chowdhuryRakibul/PICdevelopmentBoard/manual/board 1/board1.jpg

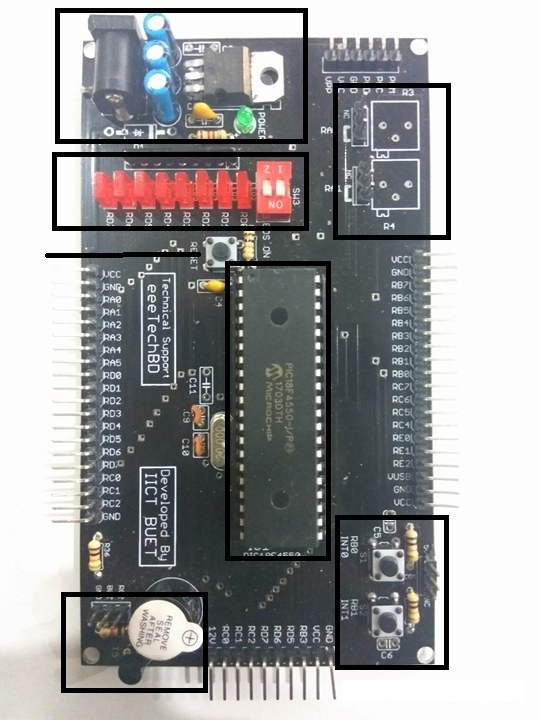
manual/board 1/board1.jpg
