chowdhuryRakibul/PICdevelopmentBoard/manual/board 1/board1_edited.jpg

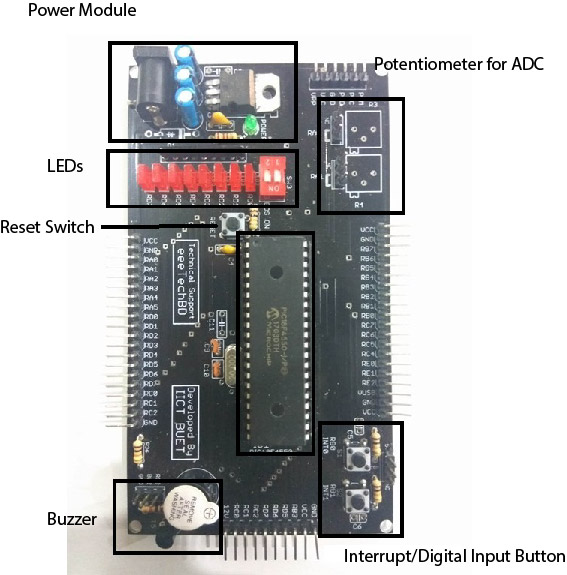
manual/board 1/board1_edited.jpg
