chowdhuryRakibul/PICdevelopmentBoard/README.md

# PICdevelopmentBoard

An educational PIC development board developed in 2017-18 for Institute of Information and Communication Technology, BUET, Dhaka.

The project contains 3 folders.
PCB includes the PCB design of individual boards using Eagle
Manual includes detailed of how to use each board with corresponding snippet of Schematic and pin mapping
Source Code includes bare-metal C/C++ code for testing basic functionalities
