chowdhuryRakibul/PICdevelopmentBoard/(list of files, drawings)

Other design files:
Source Code/Source Code/Serial Communication/Serial com.DSN
