chowdhuryRakibul/PICdevelopmentBoard/PCB/PIC Development Board.brd

## EAGLE design PCB/PIC Development Board.brd (2020-09-23)

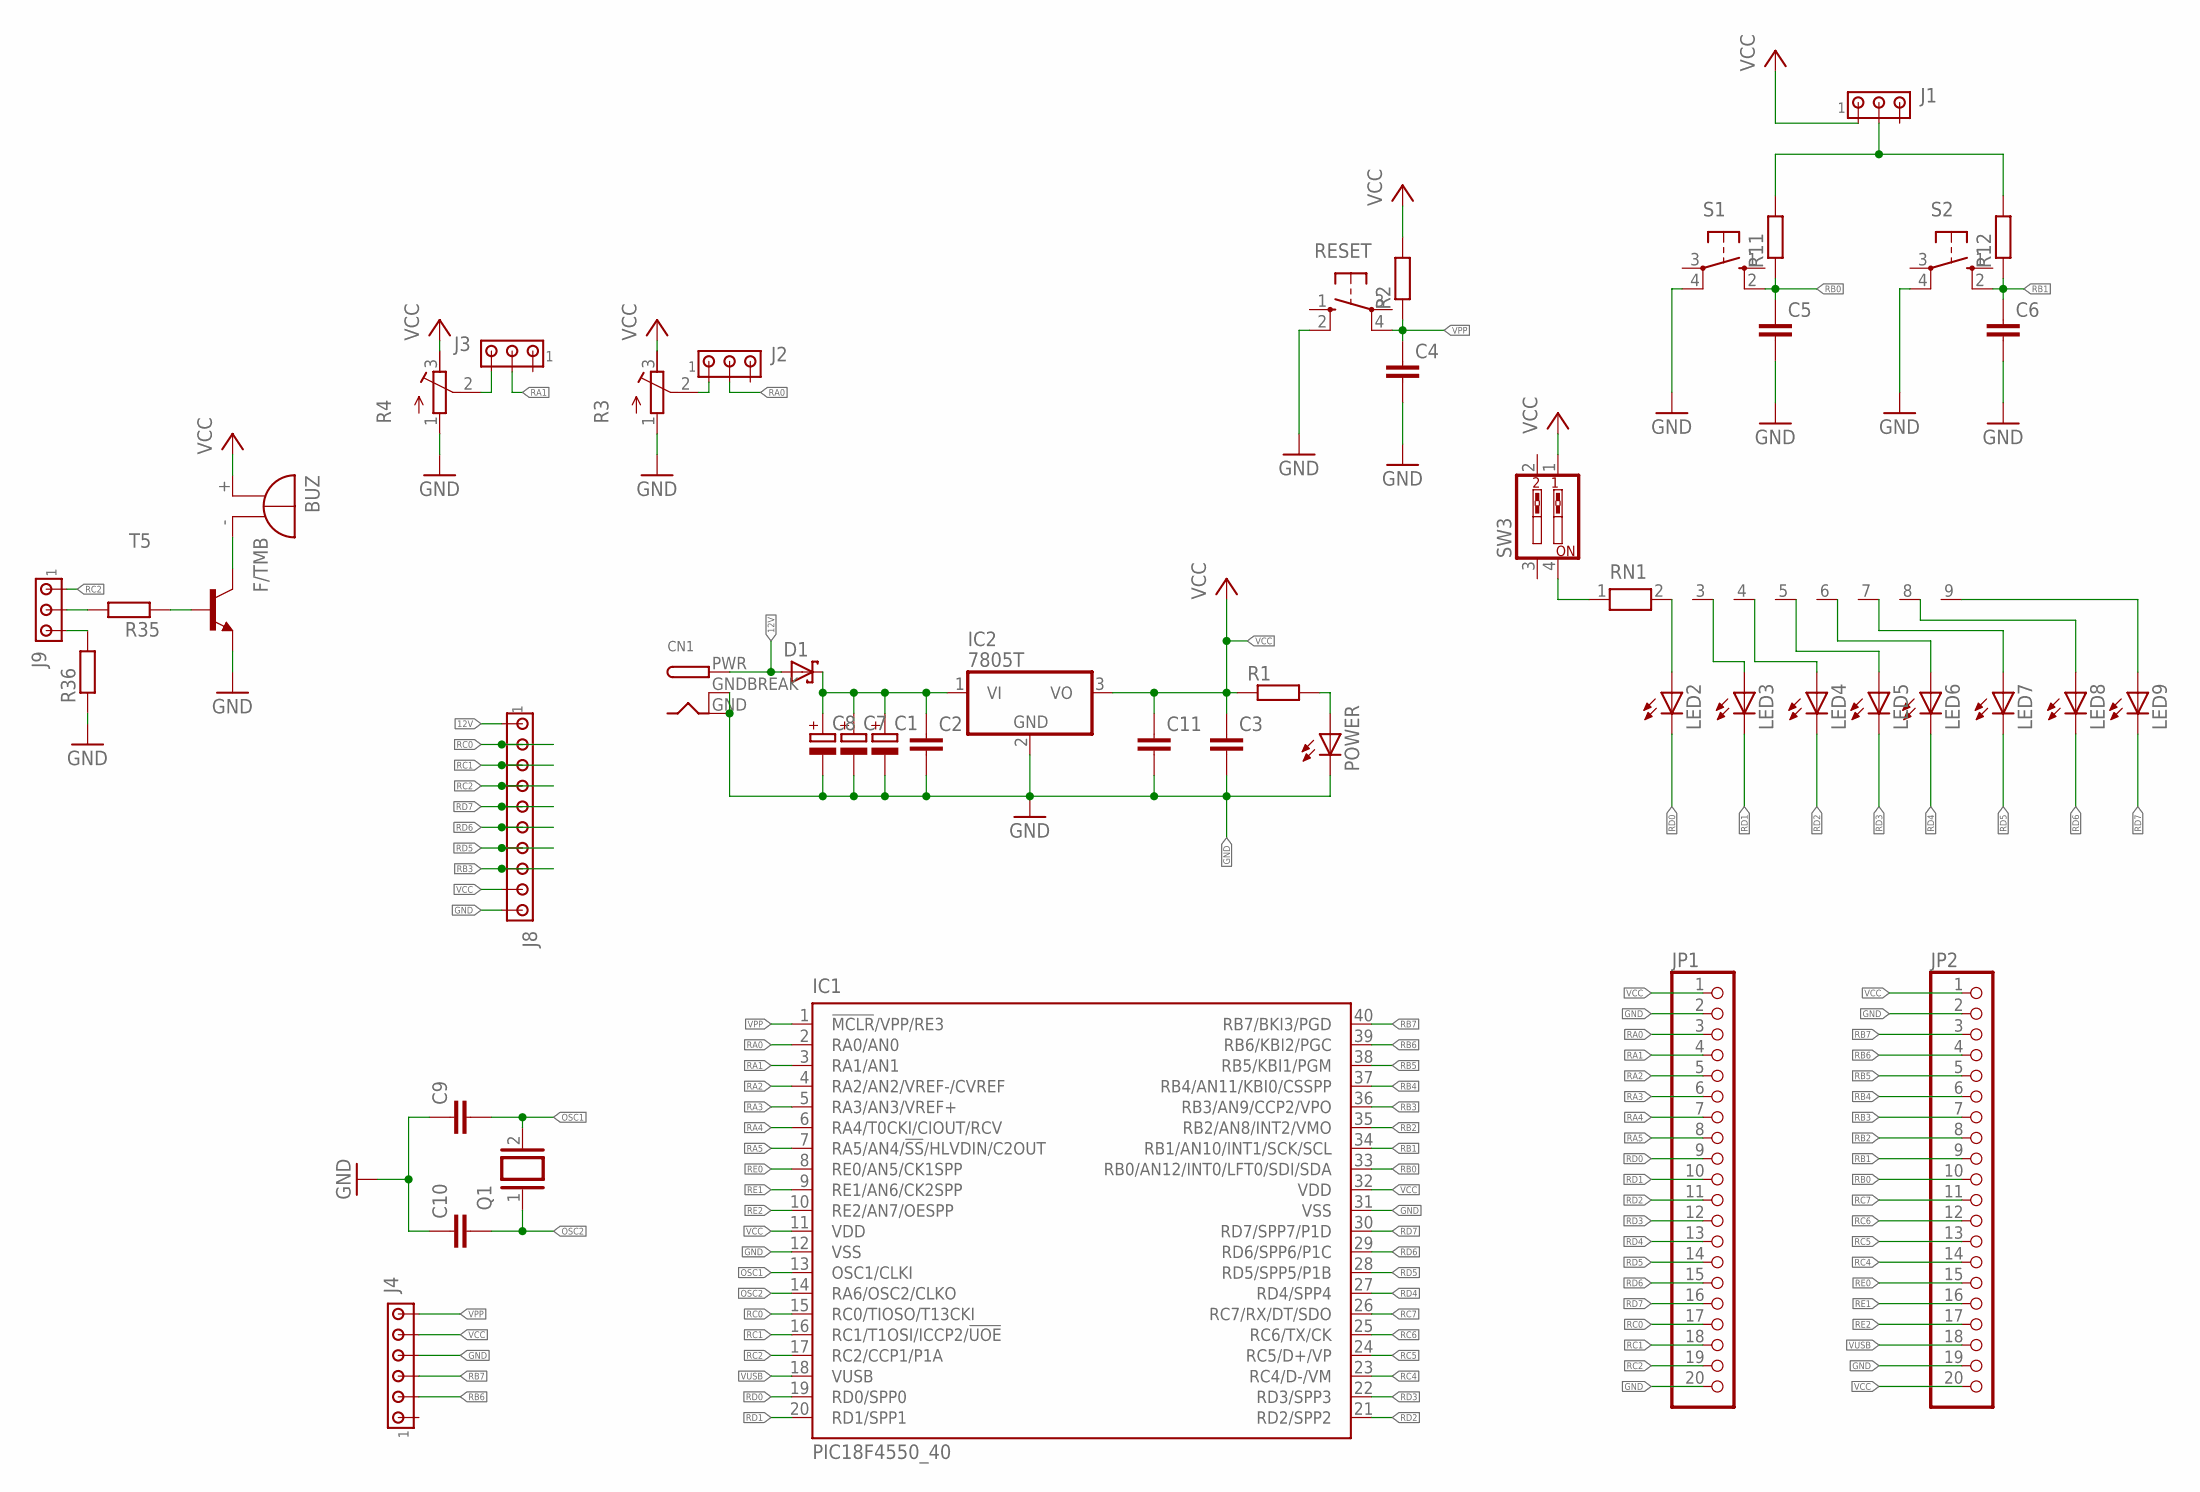
[picture p19: schematic PIC Development Board.sch, sheet 1]

Parts:
BUZ: F/TMB
C1, C7, C8: CPOL-EUE2,5-6E; E2,5-6E
C2, C3, C4, C11: C-EU050-025X075; C050-025X075
C5, C6: C-EU025-024X044; C025-024X044
C9, C10: C-EU025-030X050; C025-030X050
CN1: DCBARRELPTH; DCJACK_2MM_PTH
D1: SCHOTTKY-DIODEF126Z12; F126Z12
IC1: PIC18F4550_40; DIL40
IC2: 7805T; TO220H
J1, J2, J3, J9: MTA03-100; 10X03MTA
J4: MTA06-100; 10X06MTA
J8: MTA10-100; 10X10MTA
JP1, JP2: PINHD-1X20; 1X20
LED2, LED3, LED4, LED5, LED6, LED7, LED8, LED9: LEDSQR2X5; LED2X5
POWER: LED3MM
Q1: XTAL/S; QS
R1, R2, R11, R12, R35, R36: R-EU_0204/7; 0204/7
R3, R4: R-TRIMM3296P; RTRIM3296P
RESET: 10-XX; B3F-10XX
RN1: RN08; RN-9
S1, S2: 10-XX; B3F-10XX
SW3: SW_DIP-2; EDG-02
T5: BC547A-NPN-TO92-CBE; TO92-CBE

Connections:
12V: CN1.PWR, D1.A, J8.1
GND: C1.-, C2.2, C3.2, C4.2, C5.2, C6.2, C7.-, C8.-, C9.1, C10.1, C11.2, CN1.GND, CN1.GNDBREAK, IC1.12 (VSS), IC1.31 (VSS), IC2.2 (GND), J4.4, J8.10, JP1.2, JP1.20, JP2.2, JP2.19, POWER.K (C), R3.1 (A), R4.1 (A), R36.1, RESET.2 (S1), S1.4 (P1), S2.4 (P1), T5.E; also elsewhere on the board
unnamed: C1.+, C2.1, C7.+, C8.+, D1.C, IC2.1 (VI)
unnamed: LED2.A, RN1.2
unnamed: J9.2, R35.2
unnamed: LED3.A, RN1.3
unnamed: POWER.A, R1.2
unnamed: J2.1, R3.2 (S)
unnamed: LED4.A, RN1.4
unnamed: LED5.A, RN1.5
unnamed: LED6.A, RN1.6
unnamed: LED7.A, RN1.7
unnamed: LED8.A, RN1.8
unnamed: LED9.A, RN1.9
unnamed: J3.3, R4.2 (S)
unnamed: RN1.1, SW3.4
unnamed: J1.2, R11.2, R12.2
unnamed: BUZ.-, T5.C
unnamed: R35.1, T5.B
unnamed: J9.3, R36.2
OSC1: C9.2, IC1.13 (OSC1/CLKI), Q1.2
OSC2: C10.2, IC1.14 (RA6/OSC2/CLKO), Q1.1
RA0: IC1.2 (RA0/AN0), J2.2, JP1.3; also elsewhere on the board
RA1: IC1.3 (RA1/AN1), J3.2, JP1.4; also elsewhere on the board
RA2: IC1.4 (RA2/AN2/VREF-/CVREF), JP1.5; also elsewhere on the board
RA3: IC1.5 (RA3/AN3/VREF+), JP1.6; also elsewhere on the board
RA4: IC1.6 (RA4/T0CKI/CIOUT/RCV), JP1.7; also elsewhere on the board
RA5: IC1.7 (RA5/AN4/!SS!/HLVDIN/C2OUT), JP1.8; also elsewhere on the board
RB0: C5.1, IC1.33 (RB0/AN12/INT0/LFT0/SDI/SDA), JP2.10, R11.1, S1.2 (S1); also elsewhere on the board
RB1: C6.1, IC1.34 (RB1/AN10/INT1/SCK/SCL), JP2.9, R12.1, S2.2 (S1); also elsewhere on the board
RB2: IC1.35 (RB2/AN8/INT2/VMO), JP2.8; also elsewhere on the board
RB3: IC1.36 (RB3/AN9/CCP2/VPO), J8.8, JP2.7; also elsewhere on the board
RB4: IC1.37 (RB4/AN11/KBI0/CSSPP), JP2.6; also elsewhere on the board
RB5: IC1.38 (RB5/KBI1/PGM), JP2.5; also elsewhere on the board
RB6: IC1.39 (RB6/KBI2/PGC), J4.2, JP2.4; also elsewhere on the board
RB7: IC1.40 (RB7/BKI3/PGD), J4.3, JP2.3; also elsewhere on the board
RC0: IC1.15 (RC0/TIOSO/T13CKI), J8.2, JP1.17; also elsewhere on the board
RC1: IC1.16 (RC1/T1OSI/ICCP2/!UOE), J8.3, JP1.18; also elsewhere on the board
RC2: IC1.17 (RC2/CCP1/P1A), J8.4, J9.1, JP1.19; also elsewhere on the board
RC4: IC1.23 (RC4/D-/VM), JP2.14; also elsewhere on the board
RC5: IC1.24 (RC5/D+/VP), JP2.13; also elsewhere on the board
RC6: IC1.25 (RC6/TX/CK), JP2.12; also elsewhere on the board
RC7: IC1.26 (RC7/RX/DT/SDO), JP2.11; also elsewhere on the board
RD0: IC1.19 (RD0/SPP0), JP1.9, LED2.K (C); also elsewhere on the board
RD1: IC1.20 (RD1/SPP1), JP1.10, LED3.K (C); also elsewhere on the board
RD2: IC1.21 (RD2/SPP2), JP1.11, LED4.K (C); also elsewhere on the board
RD3: IC1.22 (RD3/SPP3), JP1.12, LED5.K (C); also elsewhere on the board
RD4: IC1.27 (RD4/SPP4), JP1.13, LED6.K (C); also elsewhere on the board
RD5: IC1.28 (RD5/SPP5/P1B), J8.7, JP1.14, LED7.K (C); also elsewhere on the board
RD6: IC1.29 (RD6/SPP6/P1C), J8.6, JP1.15, LED8.K (C); also elsewhere on the board
RD7: IC1.30 (RD7/SPP7/P1D), J8.5, JP1.16, LED9.K (C); also elsewhere on the board
RE0: IC1.8 (RE0/AN5/CK1SPP), JP2.15; also elsewhere on the board
RE1: IC1.9 (RE1/AN6/CK2SPP), JP2.16; also elsewhere on the board
RE2: IC1.10 (RE2/AN7/OESPP), JP2.17; also elsewhere on the board
VCC: BUZ.+, C3.1, C11.1, IC1.11 (VDD), IC1.32 (VDD), IC2.3 (VO), J1.1, J4.5, J8.9, JP1.1, JP2.1, JP2.20, R1.1, R2.2, R3.3 (E), R4.3 (E), SW3.1; also elsewhere on the board
VPP: C4.1, IC1.1 (!MCLR!/VPP/RE3), J4.6, R2.1, RESET.4 (P1)
VUSB: IC1.18 (VUSB), JP2.18; also elsewhere on the board

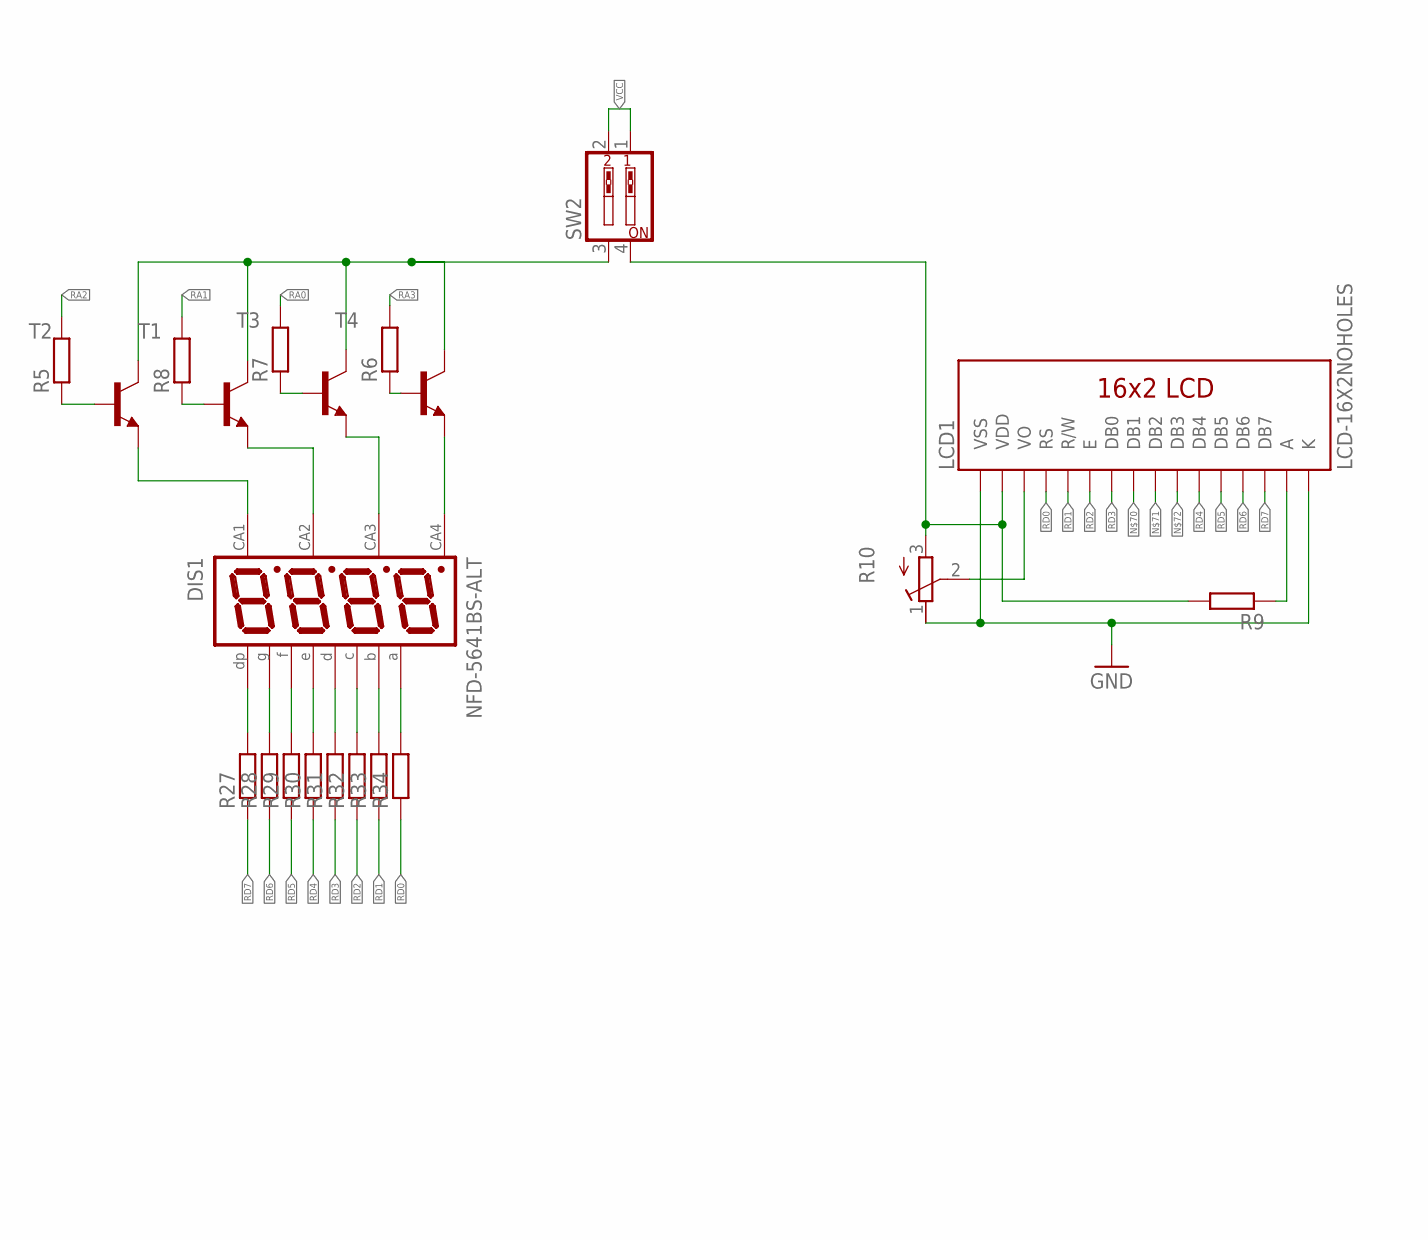
[picture p20: schematic PIC Development Board.sch, sheet 2, part in row 1, column 1]

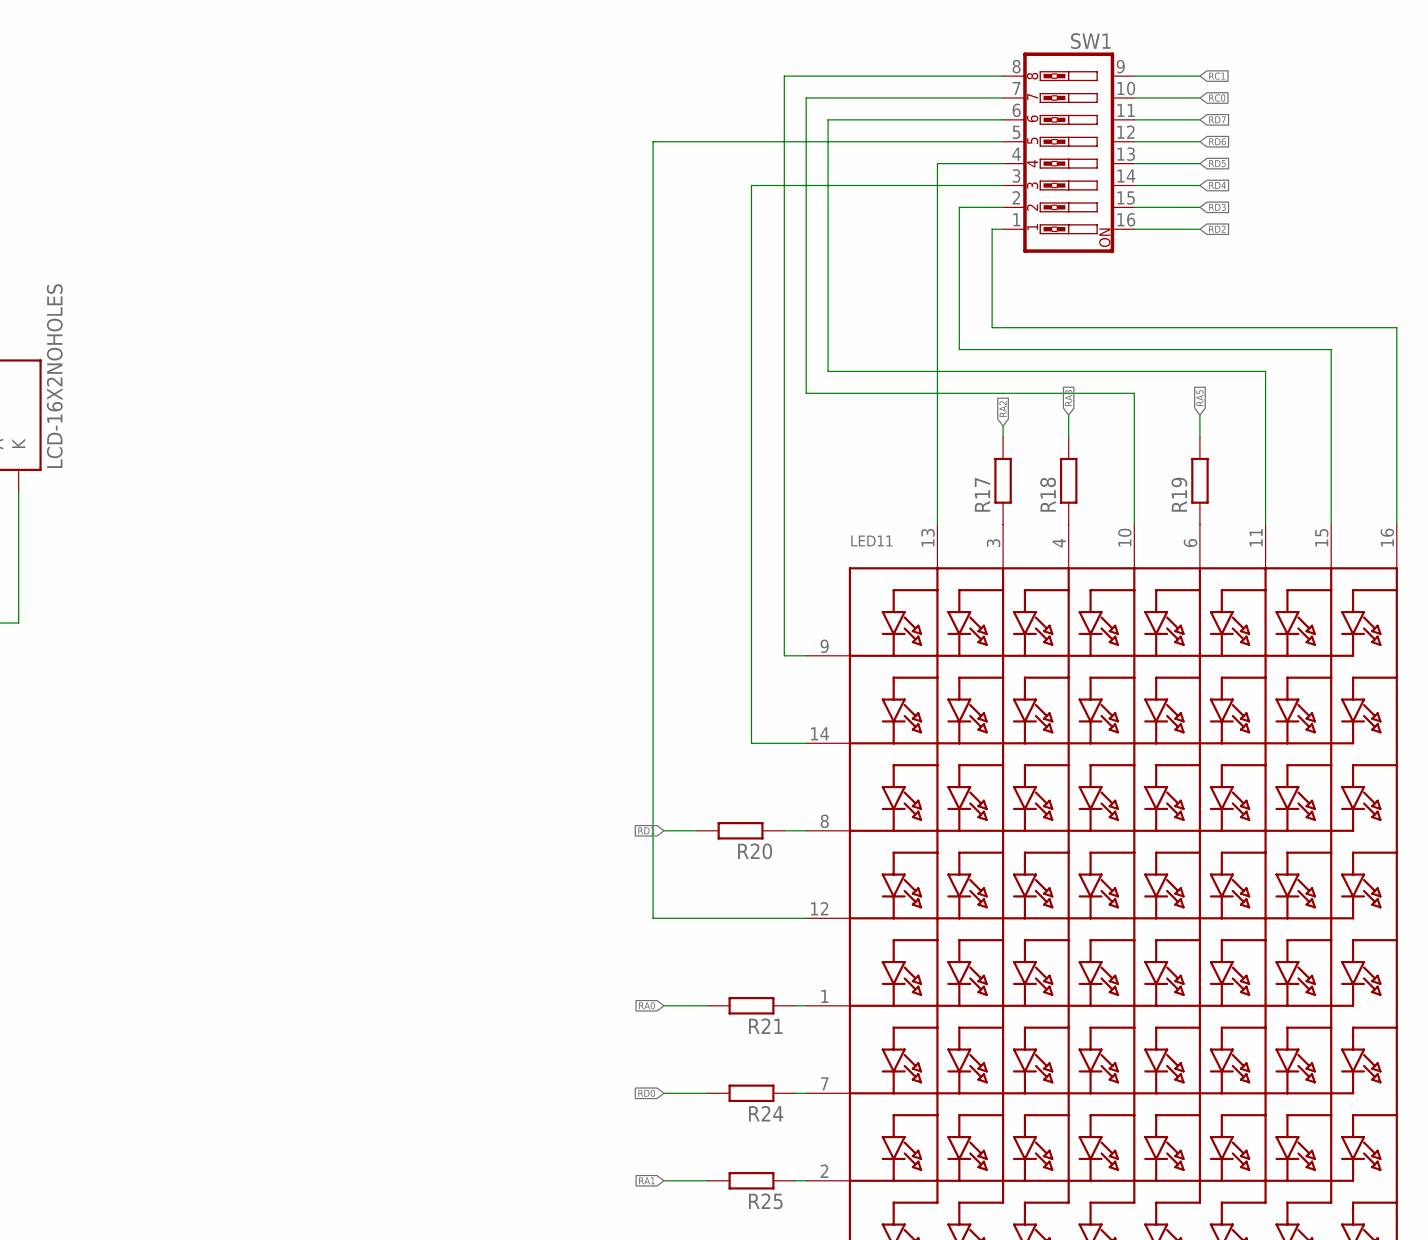
[picture p21: schematic PIC Development Board.sch, sheet 2, part in row 1, column 2]

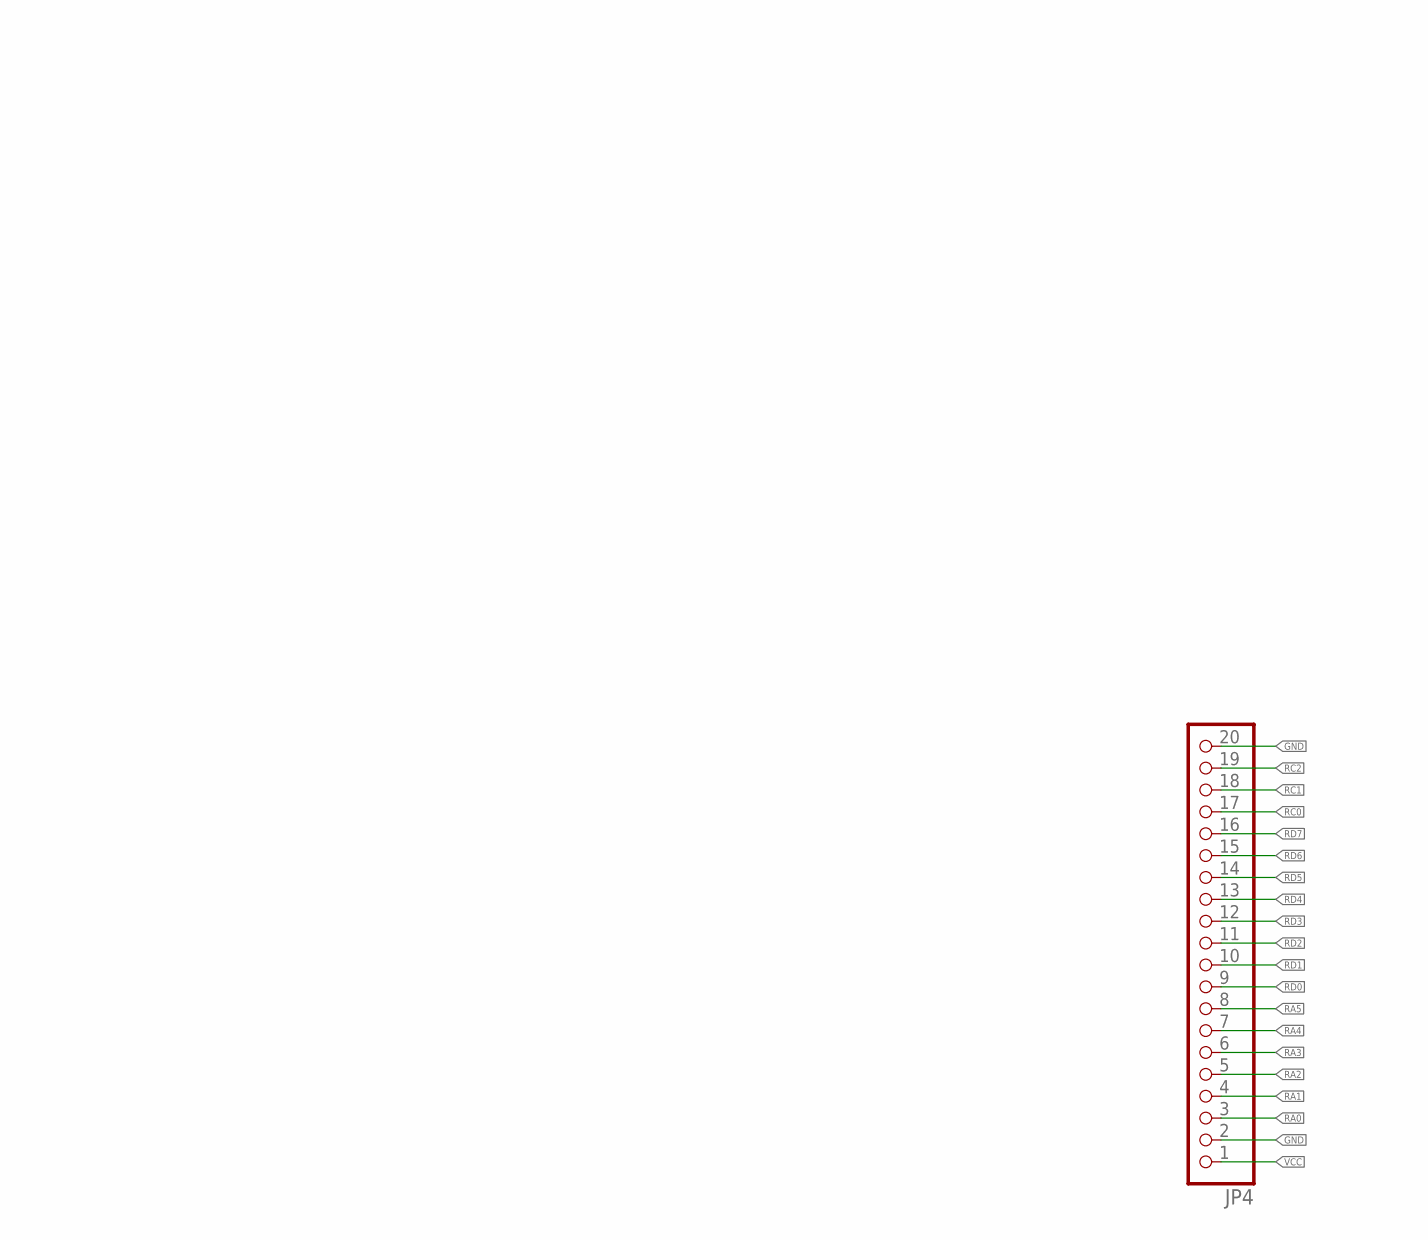
[picture p22: schematic PIC Development Board.sch, sheet 2, part in row 2, column 1]

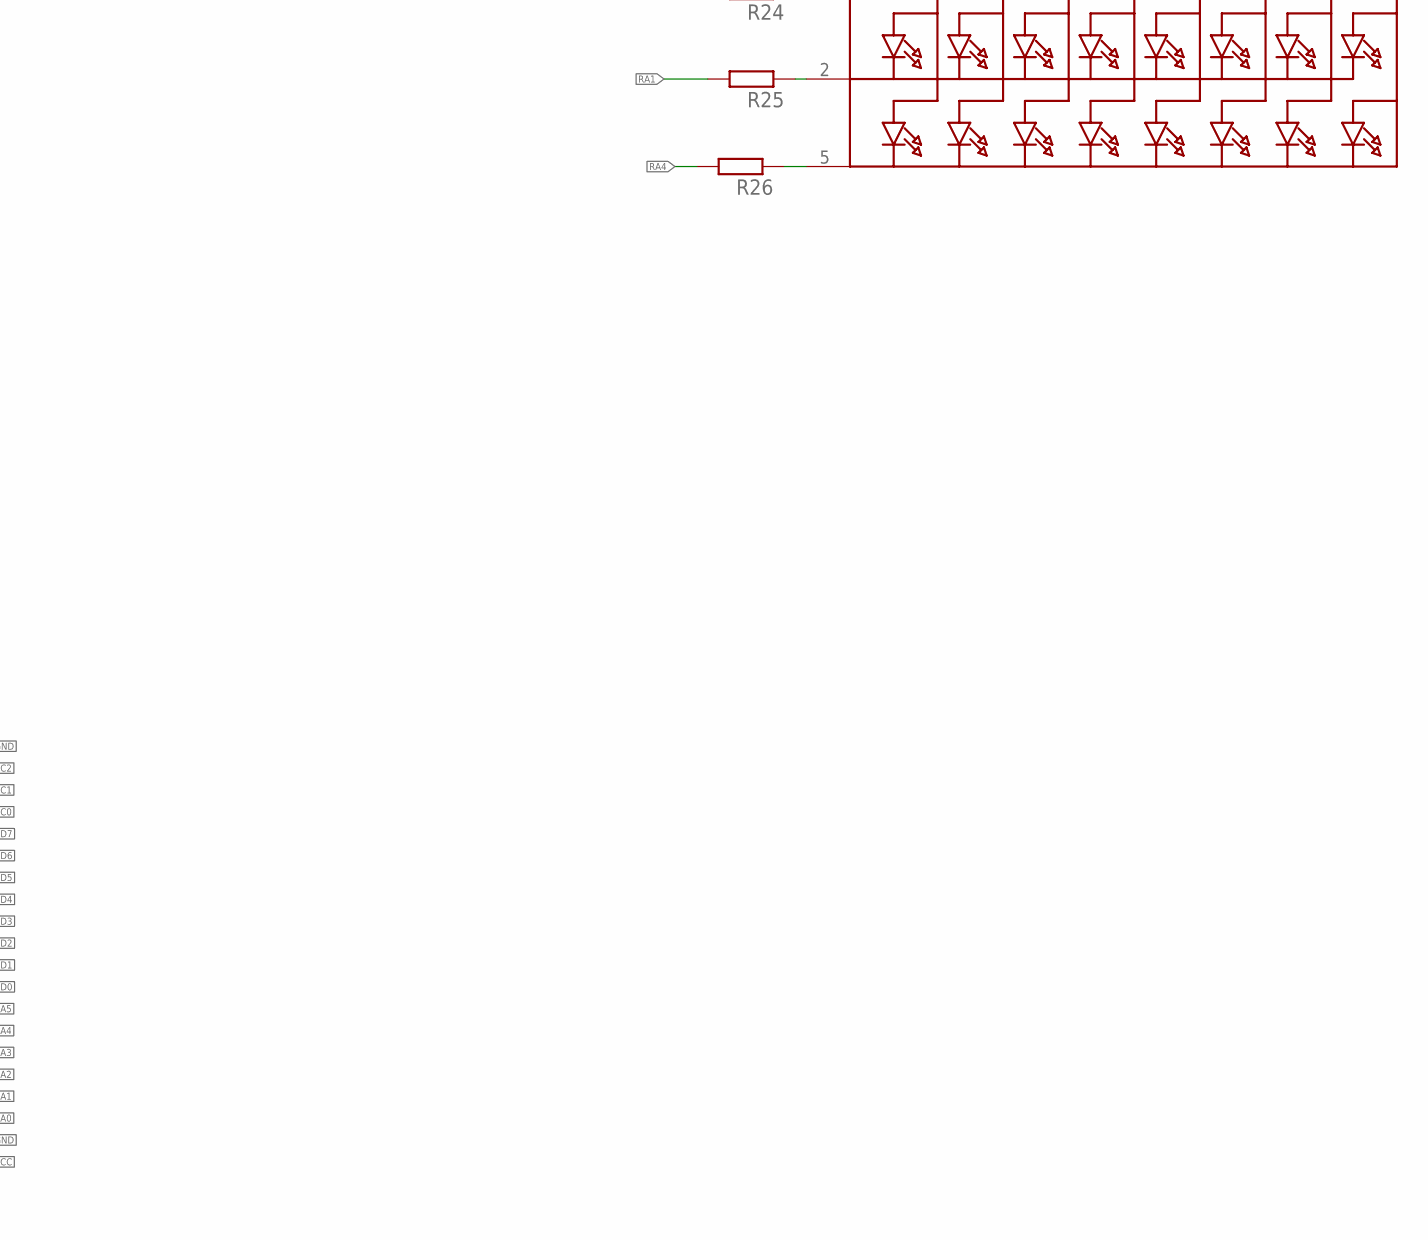
[picture p23: schematic PIC Development Board.sch, sheet 2, part in row 2, column 2]

Parts:
DIS1: NFD-5641BS-ALT; NFD-5641
JP4: PINHD-1X20; 1X20
LCD1: LCD-16X2NOHOLES; LCD-16X2_NOHOLESNOSILK
LED11: SEGMENT_8X8_ROWCATHODEM12A881UR; SEGMENT_BL-M12A881UR
R5, R6, R7, R8, R9, R17, R18, R19, R20, R21, R24, R25, R26, R27, R28, R29, R30, R31, R32, R33, R34: R-EU_0204/7; 0204/7
R10: R-TRIMMT93YA; RTRIMT93YA
SW1: SW_DIP-8; EDG-08
SW2: SW_DIP-2; EDG-02
T1, T2, T3, T4: BC547-NPN-TO92-CBE; TO92-CBE

Connections:
GND: JP4.2, JP4.20, LCD1.1 (VSS), LCD1.16 (K), R10.1 (E); also elsewhere on the board
unnamed: DIS1.P$8, T3.E
unnamed: DIS1.P$9, T1.E
unnamed: DIS1.P$12, T2.E
unnamed: LCD1.15 (A), R9.1
unnamed: LCD1.3 (VO), R10.2 (S)
unnamed: DIS1.P$6, T4.E
unnamed: SW2.3, T1.C, T2.C, T3.C, T4.C
unnamed: R6.1, T4.B
unnamed: R7.1, T3.B
unnamed: R8.1, T1.B
unnamed: R5.1, T2.B
unnamed: LCD1.2 (VDD), R9.2, R10.3 (A), SW2.4
unnamed: LED11.9 (K1), SW1.8
unnamed: LED11.10 (A4), SW1.7
unnamed: LED11.11 (A6), SW1.6
unnamed: LED11.12 (K4), SW1.5
unnamed: LED11.14 (K2), SW1.3
unnamed: LED11.6 (A5), R19.1
unnamed: LED11.4 (A3), R18.1
unnamed: LED11.3 (A2), R17.1
unnamed: LED11.8 (K3), R20.1
unnamed: LED11.1 (K5), R21.1
unnamed: LED11.7 (K6), R24.1
unnamed: LED11.2 (K7), R25.1
unnamed: LED11.5 (K8), R26.1
unnamed: DIS1.P$3, R27.2
unnamed: DIS1.P$5, R28.2
unnamed: DIS1.P$10, R29.2
unnamed: DIS1.P$1, R30.2
unnamed: DIS1.P$2, R31.2
unnamed: DIS1.P$4, R32.2
unnamed: DIS1.P$7, R33.2
unnamed: DIS1.P$11, R34.2
RA0: JP4.3, R7.2, R21.2; also elsewhere on the board
RA1: JP4.4, R8.2, R25.2; also elsewhere on the board
RA2: JP4.5, R5.2, R17.2; also elsewhere on the board
RA3: JP4.6, R6.2, R18.2; also elsewhere on the board
RA4: JP4.7, R26.2; also elsewhere on the board
RA5: JP4.8, R19.2; also elsewhere on the board
RC0: JP4.17, SW1.10; also elsewhere on the board
RC1: JP4.18, SW1.9; also elsewhere on the board
RC2: JP4.19; also elsewhere on the board
RD0: JP4.9, LCD1.4 (RS), R24.2, R34.1; also elsewhere on the board
RD1: JP4.10, LCD1.5 (R/W), R20.2, R33.1; also elsewhere on the board
RD2: JP4.11, LCD1.6 (E), LED11.16 (A8), R32.1, SW1.1, SW1.16; also elsewhere on the board
RD3: JP4.12, LCD1.7 (DB0), LED11.15 (A7), R31.1, SW1.2, SW1.15; also elsewhere on the board
RD4: JP4.13, LCD1.11 (DB4), R30.1, SW1.14; also elsewhere on the board
RD5: JP4.14, LCD1.12 (DB5), LED11.13 (A1), R29.1, SW1.4, SW1.13; also elsewhere on the board
RD6: JP4.15, LCD1.13 (DB6), R28.1, SW1.12; also elsewhere on the board
RD7: JP4.16, LCD1.14 (DB7), R27.1, SW1.11; also elsewhere on the board
VCC: JP4.1, SW2.1, SW2.2; also elsewhere on the board

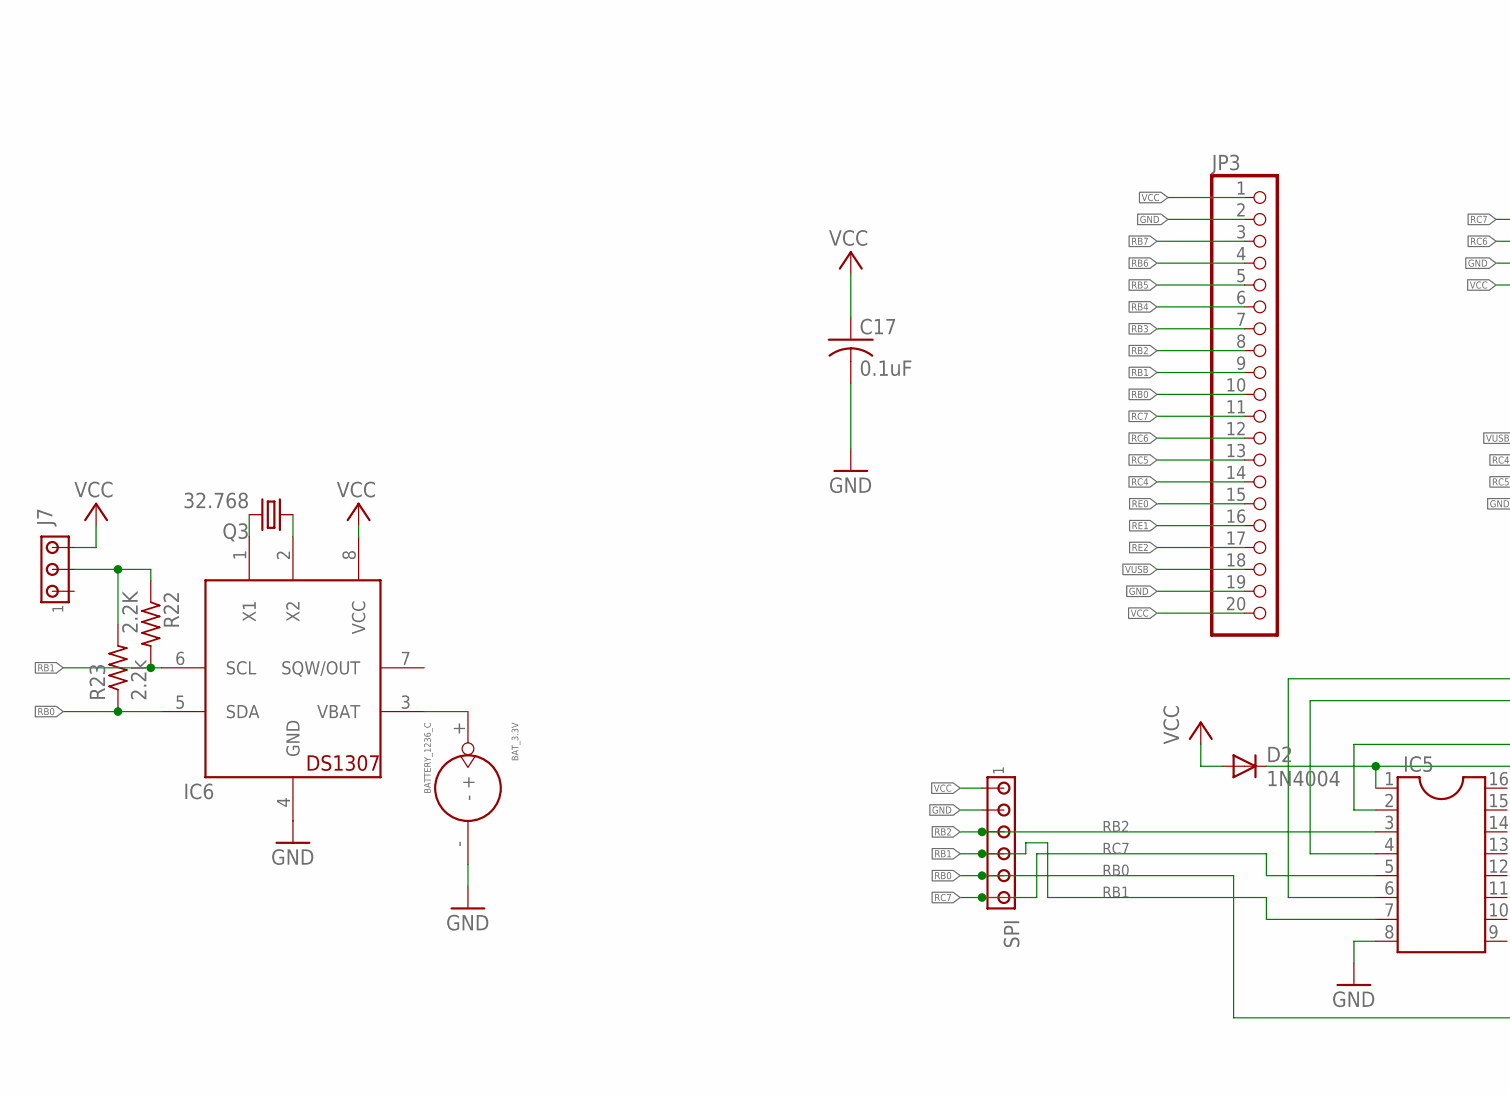
[picture p24: schematic PIC Development Board.sch, sheet 3, part in row 1, column 1]

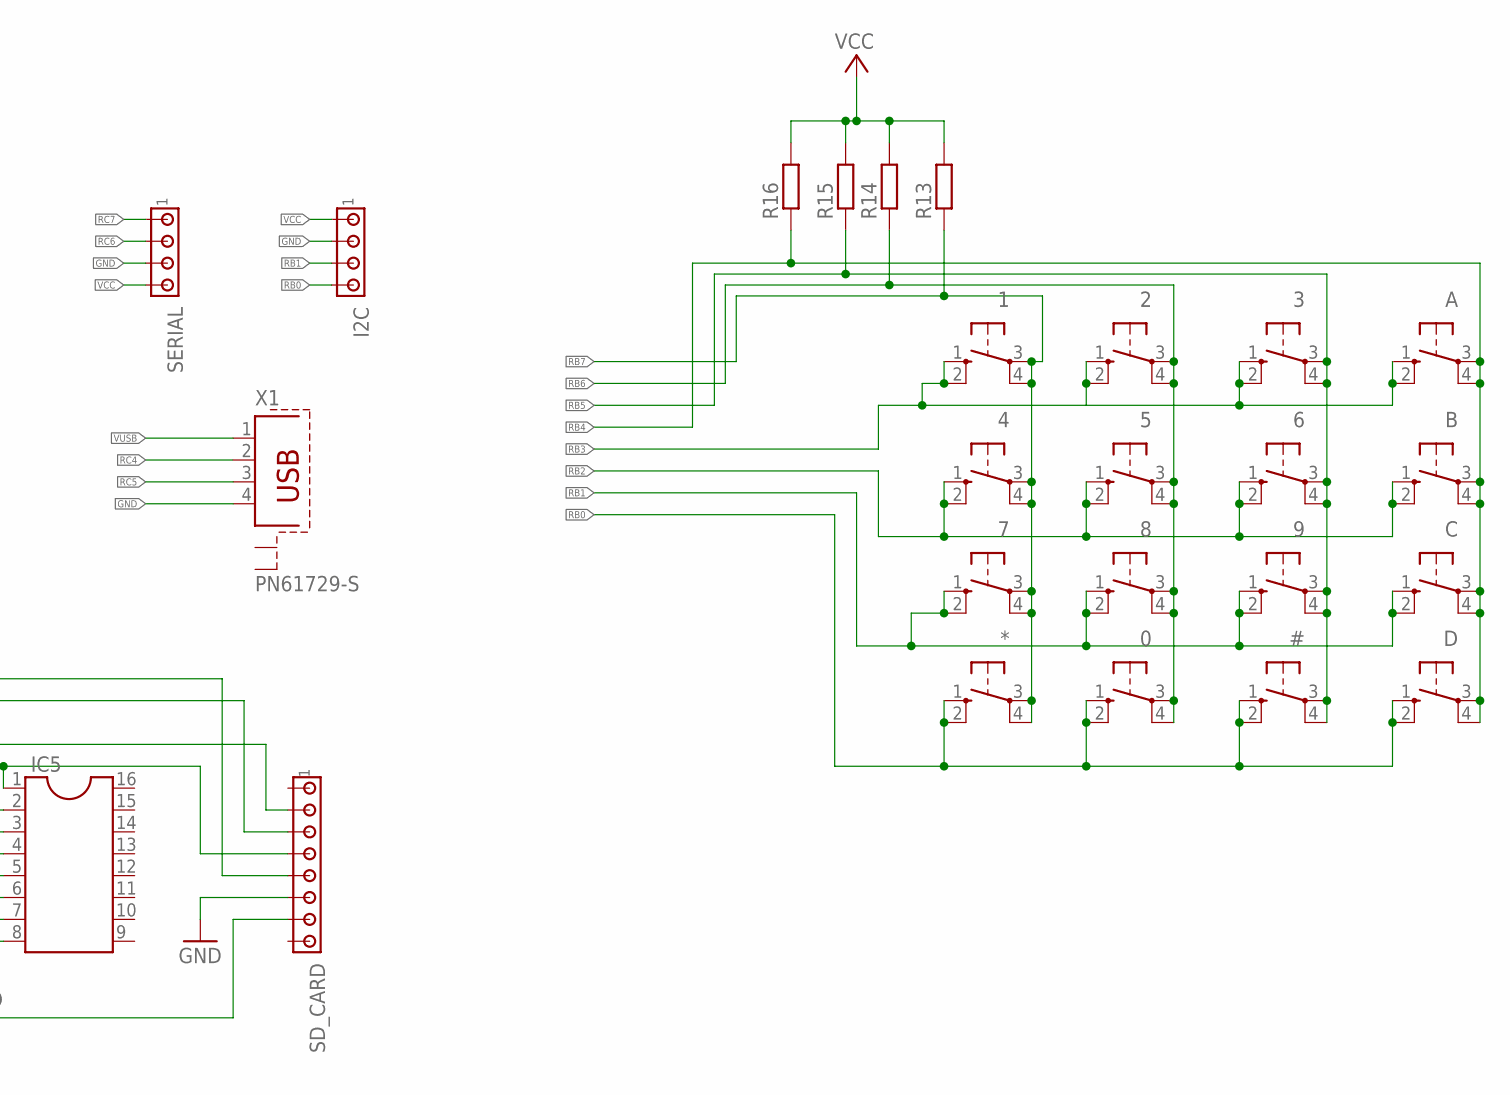
[picture p25: schematic PIC Development Board.sch, sheet 3, part in row 1, column 2]

Parts:
0, 1, 2, 3, 4, 5, 6, 7, 8, 9: 10-XX; B3F-10XX
#: 10-XX; B3F-10XX
*: 10-XX; B3F-10XX
A: 10-XX; B3F-10XX
B: 10-XX; B3F-10XX
BAT_3.3V: BATTERY_1236_C
C: 10-XX; B3F-10XX
C17: 0.1uF; C025-025X050
D: 10-XX; B3F-10XX
D2: 1N4004; DO41-10
I2C: MTA04-100; 10X04MTA
IC5: DIL16
IC6: DS1307; DIL08
J7: MTA03-100; 10X03MTA
JP3: PINHD-1X20; 1X20
Q3: 32.768; TC38H
R13, R14, R15, R16: R-EU_0204/7; 0204/7
R22: 2.2K; 0204/7
R23: 2.2k; 0204/7
SD_CARD: MTA08-100; 10X08MTA
SERIAL: MTA04-100; 10X04MTA
SPI: MTA06-100; 10X06MTA
X1: PN61729-S

Connections:
GND: BAT_3.3V.-, C17.2, I2C.2, IC5.8, IC6.4 (GND), JP3.2, JP3.19, SD_CARD.6, SERIAL.3, SPI.2, X1.4; also elsewhere on the board
unnamed: J7.2, R22.1, R23.2
unnamed: IC6.1 (X1), Q3.2
unnamed: IC6.2 (X2), Q3.1
unnamed: BAT_3.3V.+, IC6.3 (VBAT)
unnamed: D2.C, IC5.1, SD_CARD.4
unnamed: IC5.2, SD_CARD.2
unnamed: IC5.4, SD_CARD.3
unnamed: IC5.6, SD_CARD.5
RB0: 0.1 (S), 0.2 (S1), #.1 (S), #.2 (S1), *.1 (S), *.2 (S1), D.1 (S), D.2 (S1), I2C.4, IC6.5 (SDA), JP3.10, R23.1, SD_CARD.7, SPI.5; also elsewhere on the board
RB1: 7.1 (S), 7.2 (S1), 8.1 (S), 8.2 (S1), 9.1 (S), 9.2 (S1), C.1 (S), C.2 (S1), I2C.3, IC5.7, IC6.6 (SCL), JP3.9, R22.2, SPI.4; also elsewhere on the board
RB2: 4.1 (S), 4.2 (S1), 5.1 (S), 5.2 (S1), 6.1 (S), 6.2 (S1), B.1 (S), B.2 (S1), IC5.3, JP3.8, SPI.3; also elsewhere on the board
RB3: 1.1 (S), 1.2 (S1), 2.1 (S), 2.2 (S1), 3.1 (S), 3.2 (S1), A.1 (S), A.2 (S1), JP3.7; also elsewhere on the board
RB4: A.3, A.4 (P1), B.3, B.4 (P1), C.3, C.4 (P1), D.3, D.4 (P1), JP3.6, R16.1; also elsewhere on the board
RB5: 3.3, 3.4 (P1), 6.3, 6.4 (P1), 9.3, 9.4 (P1), #.3, #.4 (P1), JP3.5, R15.1; also elsewhere on the board
RB6: 0.3, 0.4 (P1), 2.3, 2.4 (P1), 5.3, 5.4 (P1), 8.3, 8.4 (P1), JP3.4, R14.1; also elsewhere on the board
RB7: 1.3, 1.4 (P1), 4.3, 4.4 (P1), 7.3, 7.4 (P1), *.3, *.4 (P1), JP3.3, R13.1; also elsewhere on the board
RC4: JP3.14, X1.2; also elsewhere on the board
RC5: JP3.13, X1.3; also elsewhere on the board
RC6: JP3.12, SERIAL.2; also elsewhere on the board
RC7: IC5.5, JP3.11, SERIAL.1, SPI.6; also elsewhere on the board
RE0: JP3.15; also elsewhere on the board
RE1: JP3.16; also elsewhere on the board
RE2: JP3.17; also elsewhere on the board
VCC: C17.1, D2.A, I2C.1, IC6.8 (VCC), J7.3, JP3.1, JP3.20, R13.2, R14.2, R15.2, R16.2, SERIAL.4, SPI.1; also elsewhere on the board
VUSB: JP3.18, X1.1; also elsewhere on the board

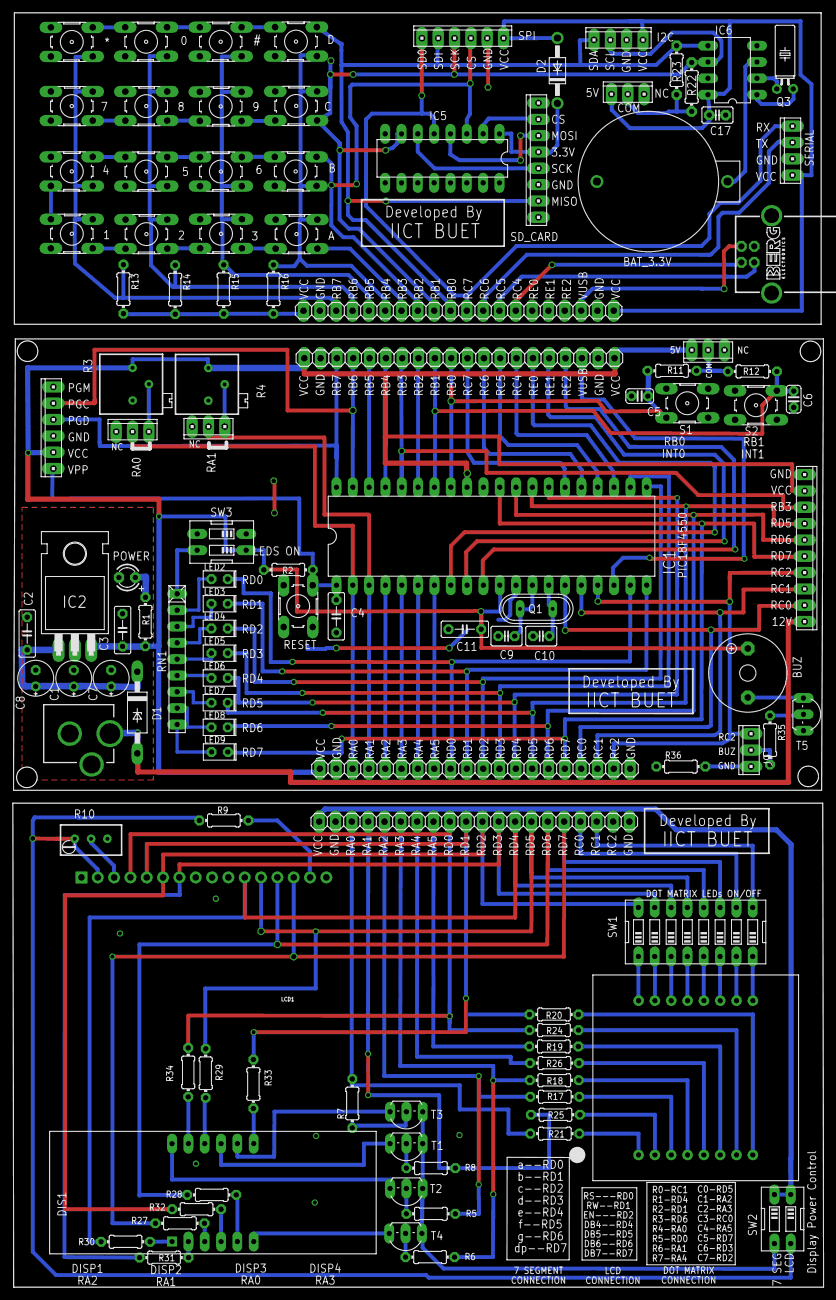
[picture p26: board PIC Development Board.brd from above]

Board: 2 copper layers, 126.1 x 198.2 mm, 115 parts (0 on the bottom side), 98 nets.
