chowdhuryRakibul/PICdevelopmentBoard/Source Code/Source Code/LCD ADC/main.c

#include <main.h>
#define LCD_ENABLE_PIN PIN_D2
#define LCD_RS_PIN PIN_D0
#define LCD_RW_PIN PIN_D1
#define LCD_DATA4 PIN_D4
#define LCD_DATA5 PIN_D5
#define LCD_DATA6 PIN_D6
#define LCD_DATA7 PIN_D7

#include <lcd.c>

void main()
{
   long adc2, adc3;
   setup_adc(ADC_CLOCK_DIV_8);               // Set ADC conversion time to 8Tosc
   setup_adc_ports(AN0_TO_AN1);
   lcd_init();

   lcd_putc("\ADC Demo..\n");

   while(TRUE)
   {
      set_adc_channel(0);                    //Select Channel to measure ADC
      delay_us(10);
      adc2 = Read_ADC();                     //Read ADC value of channel 2

      set_adc_channel(1);                    //Select Channel 3 to measure ADC
      delay_us(10);
      adc3 = Read_ADC();

      printf(lcd_putc, "\fRA2=%Lu\nRA3=%Lu", adc2, adc3);   //Print ADC values
      delay_ms(500);
   }

}
